Roman-Rice-Engineering/auto-golf-cart/bridge/pcb/bridge/3d-models/AD557JN.STEP

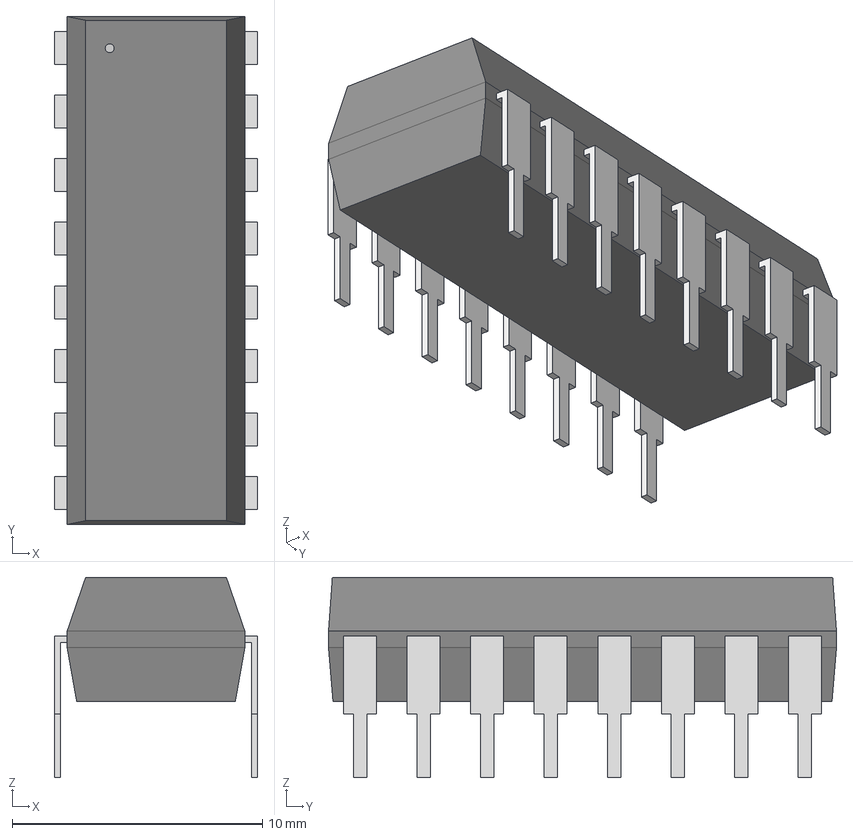
[picture p1: CAD file, 2024-02-09]
bridge/pcb/bridge/3d-models/AD557JN.STEP
8.13 x 20.3 x 8.00 mm
