Roman-Rice-Engineering/auto-golf-cart/bridge/pcb/bridge/3d-models/TERMINAL HEADER 6P.step

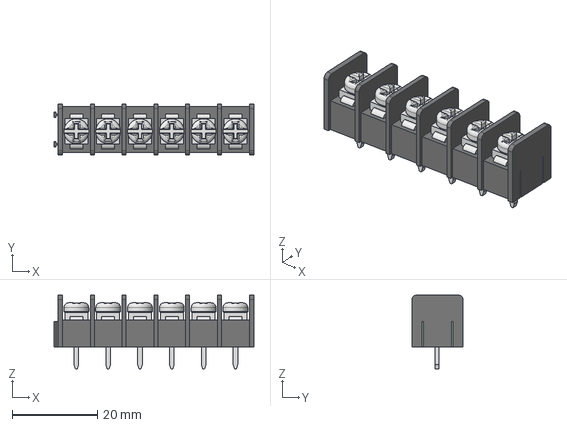
[picture p2: CAD file, 2024-02-09]
bridge/pcb/bridge/3d-models/TERMINAL HEADER 6P.step
46.9 x 12.0 x 17.3 mm
