Roman-Rice-Engineering/auto-golf-cart/bridge/pcb/bridge/3d-models/Omron_6GA-234P.STEP

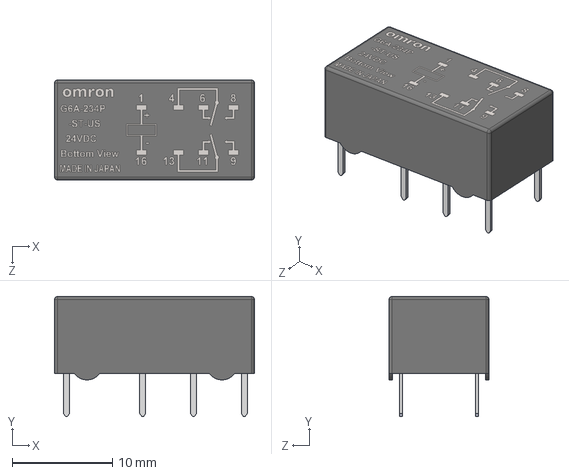
[picture p3: CAD file, 2024-02-09]
bridge/pcb/bridge/3d-models/Omron_6GA-234P.STEP
20.0 x 12.0 x 10.0 mm
