Roman-Rice-Engineering/auto-golf-cart/bridge/pcb/bridge/bridge.kicad_pcb

## KiCad design bridge/pcb/bridge/bridge.kicad_pcb (2024-06-04)

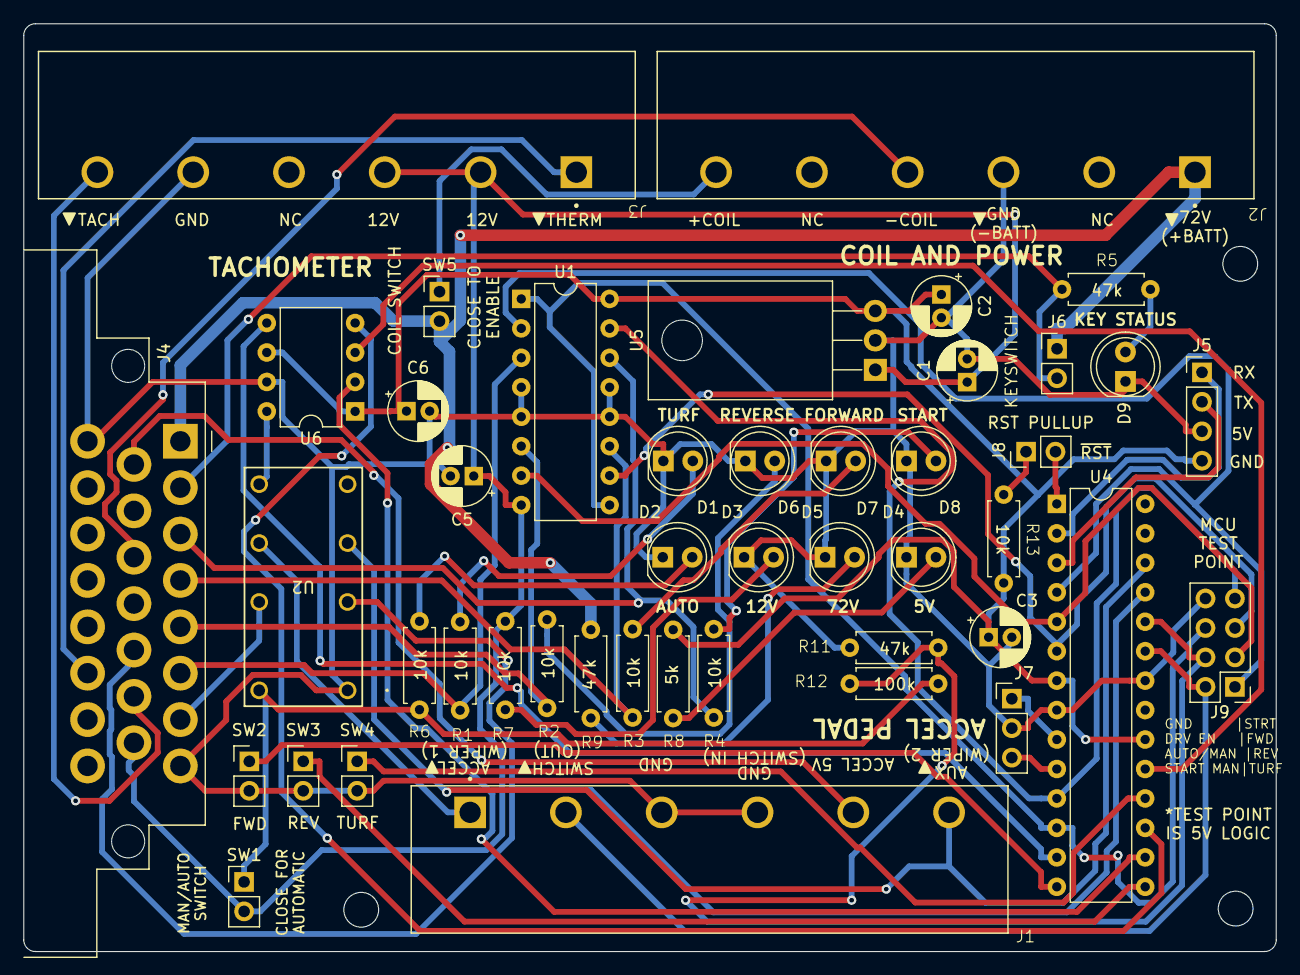
[picture p4: board bridge.kicad_pcb from above]

Board: 2 copper layers, 108.0 x 80.0 mm, 45 parts (0 on the bottom side), 49 nets.

Parts:
C1, C2, C3, C5, C6: 1u; CP_Radial_D5.0mm_P2.00mm
D1, D6, D7, D8: YELLOW; LED_D5.0mm
D2: BLUE; LED_D5.0mm
D3, D4, D5: RED; LED_D5.0mm
D9: GREEN; LED_D5.0mm
J1, J2, J3: Screw_Terminal_01x06; TE_2-1437667-9
J4: Conn_01x23; TE_AMPSEAL_1-776087-x_3Rows_23_P0.4mm_Horizontal
J5: Conn_01x04; PinHeader_1x04_P2.54mm_Vertical
J6, J8: Conn_01x02; PinHeader_1x02_P2.54mm_Vertical
J7: Conn_01x03; PinHeader_1x03_P2.54mm_Vertical
J9: MCU_Test_Point; PinHeader_2x04_P2.54mm_Vertical
R1, R2, R3, R4, R6, R7, R13: 10k; THT_RESISTOR_WITH_VALUE
R5, R9, R11: 47k; THT_RESISTOR_WITH_VALUE
R8: 5k; THT_RESISTOR_WITH_VALUE
R12: 100k; THT_RESISTOR_WITH_VALUE
SW1, SW2, SW3, SW4, SW5: SW_SPST; PinHeader_1x02_P2.54mm_Vertical
U1: L293; DIP-16_W7.62mm
U2: J104D2C12VDC.20S; RELAY8_J104D2C12VDC.20S_CRS
U4: ATmega328P-P; DIP-28_W7.62mm
U5: L7805; TO-220-3_Horizontal_TabDown
U6: MCP4901; DIP-8_W7.62mm

Connections:
+5V: C2.1, C3.1, C6.1, J5.4, R8.1, R13.2, U1.16 (VCC1), U4.7 (VCC), U4.20 (AVCC), U5.3 (OUT), U6.1 (Vdd), U6.6 (Vref)
+12V: C1.1, C5.1, J3.2, J3.3, J4.15, R7.1, SW1.2 (B), U1.8 (VCC2), U5.1 (IN)
+BATT: J2.1, J4.1, J6.1, R9.1, SW5.2 (B)
/5V_LED_A: D4.2 (A), R8.2
/12V_LED_A: D3.2 (A), R7.2
/72V_LED_A: D5.2 (A), R9.2
/AUTO_MAN_LED_A: D2.2 (A), R6.2
ACCEL_AUTO: U2.5, U6.8 (Vout)
ACCEL_AUX_MAN: J1.6, U2.3, U4.26 (PC3)
ACCEL_MAN: J1.1, U2.6
ACCEL_POT: J4.7, U2.7
ACCEL_POT_5V: J1.5, J4.9
ACCEL_POT_AUX: J4.13, U2.2, U4.25 (PC2)
COIL_CONTROL_GND: J2.4, J4.11
DAC_SS: U4.16 (PB2), U6.2 (~CS)
DRV_ENABLE: J9.6, U1.1 (EN1,2), U1.9 (EN3,4), U4.12 (PD6)
FORWARD_MAN: SW2.1 (A), U4.14 (PB0)
FORWARD_SWITCH: J4.4, R3.1, U1.11 (3Y)
GND: C1.2, C2.2, C3.2, C5.2, C6.2, D1.1 (K), D2.1 (K), D3.1 (K), D4.1 (K), D5.1 (K), D6.1 (K), D7.1 (K), D8.1 (K), D9.1 (K), J1.3, J1.4, J2.3, J3.5, J4.8, J4.16, J5.3, J7.2, J9.8, R11.1, SW2.2 (B), SW3.2 (B), SW4.2 (B), U1.4 (GND), U1.5 (GND), U1.12 (GND), U1.13 (GND), U2.1, U4.8 (GND), U4.22 (GND), U5.2 (GND), U6.7 (Vss)
KEYSWITCH: J4.2, J6.2, R5.1
LDAC: U4.13 (PD7), U6.5 (~LDAC)
MAN_AUTO_STATE: J9.4, R11.2, R12.1, U4.24 (PC1)
MCU_FORWARD: J9.5, U1.10 (3A), U4.6 (PD4)
MCU_REVERSE: J9.3, U1.7 (2A), U4.5 (PD3)
MCU_START: J9.7, U1.15 (4A), U4.11 (PD5)
MCU_TURF: J9.1, U1.2 (1A), U4.4 (PD2)
unnamed: D1.2 (A), R1.2
unnamed: D6.2 (A), R2.2
unnamed: D7.2 (A), R3.2
unnamed: D8.2 (A), R4.2
unnamed: D9.2 (A), R5.2
unnamed: J2.6, SW5.1 (A)
unnamed: J5.1, U4.2 (PD0)
unnamed: J5.2, U4.3 (PD1)
unnamed: J7.1, U4.9 (XTAL1/PB6)
unnamed: J7.3, U4.10 (XTAL2/PB7)
unnamed: J8.1, R13.1
unnamed: J8.2, U4.1 (~RESET/PC6)
unnamed: R6.1, R12.2, SW1.1 (A), U2.8
REVERSE_MAN: SW3.1 (A), U4.15 (PB1)
REVERSE_SWITCH: J4.5, R2.1, U1.6 (2Y)
SPI_MOSI: U4.17 (PB3), U6.4 (SDI)
SPI_SCK: U4.19 (PB5), U6.3 (SCK)
START_SWITCH: J4.3, R4.1, U1.14 (4Y)
START_SWITCH_NEG_MAN: J1.2, J9.2, U4.23 (PC0)
TACH_PULSE: J3.6, J4.14
THERMOSTAT: J3.1, J4.21
TURF_MAN: SW4.1 (A), U4.18 (PB4)
TURF_SWITCH: J4.6, R1.1, U1.3 (1Y)
