Roman-Rice-Engineering/auto-golf-cart/(commit log)

2023-11-08 Set up shematic for bridge pcb
    - Set up the inputs and outputs for the bridge pcb board
    - Labelled which pins connect to what
    [bridge.kicad_pcb, bridge.kicad_sch]
2023-11-10 Completed schematic I/O connections
    [bridge.kicad_sch]
2024-02-08 Changed circuit board setup to one board bridge
    [bridge.kicad_sch]
2024-02-09 Added basic functions to PCB
    [Omron_6GA-234P.STEP, TERMINAL HEADER 6P.step, bridge.kicad_pcb, bridge.kicad_sch, mcu.kicad_sch]
2024-02-09 Fixed issues, added DAC
    [AD557JN.STEP, bridge.kicad_pcb, bridge.kicad_sch, mcu.kicad_sch]
2024-02-09 Changed PCB to use correct tht resistor footprint
    [bridge.kicad_pcb]
2024-02-09 Completed schematic
    [bridge.kicad_pcb, bridge.kicad_sch, mcu.kicad_sch]
2024-02-09 Completed routing of PCB
    [bridge.kicad_pcb, bridge.kicad_sch]
2024-02-12 Completed silkscreen
    [bridge.kicad_pcb]
2024-02-12 Changed board size to make ordering cheaper
    [bridge.kicad_pcb]
2024-03-07 Rounded board outline
    [bridge.kicad_pcb]
2024-04-06 Started fixing PCB, reduced footprint and changed MCU
    [bridge.kicad_pcb, mcu.kicad_sch]
2024-04-08 Completed basic functionality PCB
    [bridge.kicad_pcb, mcu.kicad_sch]
2024-04-30 Fixed incorrect test point labeling
    [bridge.kicad_pcb]
2024-04-30 Fixed PORTB and PORTD of atmega328p being reversed
    Changed RST pin on uart header to be 5V instead and adjusted labels accordingly
    [bridge.kicad_pcb, mcu.kicad_sch]
2024-04-30 Seperated 5V for accel pot and main 5V supply
    Added 5V and 12V enable PCB headers
    [bridge.kicad_sch, mcu.kicad_sch]
2024-04-30 Added capacitors near important components
    [mcu.kicad_sch]
2024-04-30 Added status LED's for all of the motor controller switches
    [bridge.kicad_sch, mcu.kicad_sch]
2024-04-30 Connected ACCEL_POT_MAN and ACCEL_POT_AUX to analog pins 2 and 3 of atmega328p
    [mcu.kicad_sch]
2024-04-30 Assigned footprints and layed out board
    Removed 5V and 12V enable headers as they added unneeded complexity
    [bridge.kicad_pcb, bridge.kicad_sch, mcu.kicad_sch]
2024-04-30 Added extra capacitor for L293
    [bridge.kicad_pcb, mcu.kicad_sch]
2024-04-30 Completed autorouter routing
    [bridge.kicad_pcb]
2024-04-30 Added needed silkscreen labels for new design
    [bridge.kicad_pcb]
2024-05-01 Changed PCB back to 2 layer
    [bridge.kicad_pcb]
2024-05-20 Created a blank arduino sketch, created a basic config file
2024-05-22 Fixed include order in stringparser.h
    [bridge.ino, stringparser.h]
2024-05-22 Completed an untested version of v0.2 PCB comptible firmware
2024-05-23 Fixed a bug which caused inverse of configured NC setting to be used
    [manual.cpp]
2024-06-04 Changed DAC to MCP4901
    [mcu.kicad_sch]
2024-06-04 Added connector for manual mode forward and reverse signals
    [mcu.kicad_sch]
2024-06-04 Reversed 5V and GND on serial connector symbol
    [mcu.kicad_sch]
2024-06-04 Fixed schematic for manual forward, reverse, and turf switches
    Seperated forward and reverse
    Added turf
    Changed schematic to use switch symbol instead of connector generic
    [mcu.kicad_sch]
2024-06-04 Assigned footprints and added new components to PCB
    [bridge.kicad_pcb, mcu.kicad_sch]
2024-06-04 Added clarification to silkscreen for main power input connections
    [bridge.kicad_pcb]
2024-06-04 Updated resistor values to make LEDs brighter
    [bridge.kicad_pcb, bridge.kicad_sch, mcu.kicad_sch]
2024-06-04 Improved connector labeling and added more detail
    Labeled wiper 1 and wiper 2 for accel pedal
    Changed +/- to be before COIL instead of after i.e. "-COIL" instead of "COIL-"
    [bridge.kicad_pcb]
2024-06-04 Adjusted LED colors
    [bridge.kicad_pcb, bridge.kicad_sch, mcu.kicad_sch]
2024-06-04 Added switch for contactor coil, adjusted labeling
    Slightly changed labels for the KEY and MAN/AUTO switches
    [bridge.kicad_pcb, bridge.kicad_sch]
2024-06-04 Added a version marker and credits to PCB
    [bridge.kicad_pcb]
2024-06-04 Routed circuit board
    [bridge.kicad_pcb]
2024-06-04 Improved label for start switch input and output
    [bridge.kicad_pcb]
2024-06-04 Changed config.h to fit v0.3 PCB and removed dac.h implementation
2024-06-04 Added turf switch control code to manual.cpp
